supernach00/AGSE-Proyecto-Final/Informe/Proyecto_Zero-1.pdf

# Proyecto Zero

# Chantiri, Ignacio Nahuel 69869/1 Fernandez Madau, Esteban 71271/5

## Facultad de Ingeniería de la Universidad Nacional de La Plata, 2026

### 1. Resumen

Se propone el diseno del generador digital-anal ˜ | ogico de se ´ | nales en el rango auditivo com- ˜
prendido entre 5Hz y 5KHz, y la comunicacion del producto final con el software de PC que ´ permite el control y la visualizacion de los datos. ´
Este proyecto comprende una aproximacion a la s ´ | íntesis de senales digitales, particularmen- ˜
te del tipo senoidal y a la seleccion de un microcontrolador adecuado para proyecto. ´

### 2. Objetivos

Este Proyecto Zero tiene los siguientes objetivos particulares:
Determinar los requerimientos que demanda el proyecto total para poder realizar una correcta eleccion del microcontrolador. ´
Familizarizarse con el microcontrolador elegido y las herramientas ofrecidas por el fabricante del mismo.
Estudiar la viabilidad de las distintas maneras de generar la senal de manera digital, de- ˜ terminar los límites o complicaciones con el microcontrolador elegido.
Implementar la generacion digital de una se ´ | nal senoidal de dos canales, de par ˜ | ametros ´
variables (frecuencia y amplitud) por comandos desde la pc.

### 3. Tareas realizadas y resultados obtenidos

### 3.1 Eleccion del Microcontrolador ´

Se lista, en orden de importancia, las características del microcontrolador STM32F446RCT7 y las razones que llevaron a su eleccion para este proyecto. ´
1. Interfaz SAI / I²S: dispone de interfaces de audio digital adecuadas para la comunicacion´ con un codec, permitiendo transmitir y recibir muestras digitales de hasta 24 bits.
2. DMA: permite transferir automaticamente las muestras entre la memoria y los perif ´ | ericos ´
de audio, reduciendo la carga de procesamiento de la CPU y facilitando la transmision´ continua de senales. ˜
3. Frecuencia de operacion: ´ | hasta 180 MHz, proporcionando un amplio margen de proce-
samiento para la generacion y adquisici ´ | on de se ´ | nales en tiempo real. ˜
4. Temporizadores: dispone de multiples temporizadores que permiten establecer una fre- ´
cuencia de muestreo precisa y generar las senales de sincronizaci ˜ | on necesarias para el ´
procesamiento de audio.
5. N úcleo ARM Cortex-M4 con DSP: incorpora instrucciones específicas para procesa-
miento digital de senales, ˜ | utiles para implementar filtros, generaci ´ | on de se ´ | nales y algo- ˜
ritmos de procesamiento.
6. Unidad de punto flotante (FPU): permite realizar operaciones en punto flotante de preci-
sion simple de manera eficiente, facilitando la implementaci ´ | on de algoritmos matem ´ | aticos ´
y de procesamiento de senales. Se toma en cuenta puesto que se contempla que otra ˜
parte del proyecto requiera calculos demandantes para procesamiento de se ´ | nales. ˜
7. Memoria SRAM: dispone de 128 KB de SRAM, permitiendo almacenar buffers de audio y datos utilizados durante el procesamiento en tiempo real.
8. Memoria Flash: dispone de 256 KB de memoria Flash, suficiente para almacenar el firmware, tablas de consulta (LUT) y constantes utilizadas por el sistema.
9. DAC: incorpora dos convertidores digital–analogico de 12 bits, ´ | utiles para realizar prue- ´
bas de generacion de se ´ | nales directamente desde el microcontrolador, como se da en ˜
este Proyecto Zero.
10. Capacidad para implementar DDS: Todo lo mencionado permite implementar un sintetizador digital directo mediante un acumulador de fase y una tabla de consulta (LUT),
posibilitando la generacion de se ´ | nales sinusoidales y otras formas de onda con frecuencia ˜
configurable.
Se contemplaron ademas otros microcontroladores con características similares ´
como el stm32f411, pero la seleccion termin ´ | o decantando en base a la accesibili- ´
dad de los mismos.
3.2 Generacion de la se ´ | nal sinusoidal ˜

El siguiente diagrama busca representar el algoritmo implementado por codigo en el micro- ´ controlador. El objetivo es lograr controlar independientemente dos canales de audio (dos DACs), generando la senal senoidal que puede ser modificable tanto en frecuencia como en ˜ amplitud.
La síntesis digital se basa en el uso de una tabla (LUT) para acceder a los distintos valores de la senal senoidal. La tabla se recorre con un cierto paso configurable (FTW), permitiendo ˜ variar la frecuencia de la senal de salida. La amplitud se modula escalando los valores de ˜ dicha tabla.
El acumulador de fase (acc) corresponde a una variable de 32 bits que va incrementando
segun el FTW cada tiempo de muestreo ´ | fs (48Khz, fijado por el codec que se utilizara a ´
futuro). El valor almacenado de la fase luego se utiliza para acceder a la LUT, truncando previamente para adaptar a la cantidad de puntos de la tabla.

Por ultimo se aplica un control de amplitud de varios pasos, que incluye el centrado a cero, ´ escalado y descentrado nuevamente de la senal para luego ser enviada al DAC. ˜
La generacion implementada trabaja con dos canales (L/R), por lo que el proceso que ´ se describio se realiza de manera similar y en ”paralelo”para ambos. ´

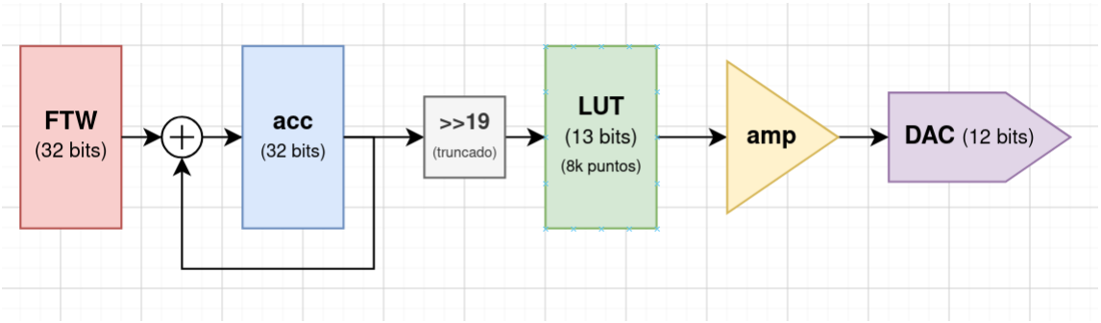
[picture p9: figure]

Algoritmo de Síntesis de la Senal Senoidal ˜

La LUT se selecciono con 8192 puntos, utilizando 13 bits del acumulador de fase para su ´ direccionamiento. Esta cantidad de puntos permite obtener una resolucion angular suficien- ´ temente elevada, reduciendo el error asociado al truncamiento de fase.
Ademas, se consider ´ | o el tama ´ | no que ocupa en flash: 8192 * 2Bytes = 16.384 Bytes, despre- ˜
ciable considerando el total de 256Kbytes
De esta manera, la frecuencia de la senal generada queda definida por: ˜

fout =

F TW
2N

fs

donde:

fs = 48 kHz es la frecuencia de muestreo.

N = 32 es la cantidad de bits del acumulador de fase.

F TW es la palabra de ajuste de frecuencia.

Si se utilizan los 13 bits mas significativos del acumulador para determinar el ´ | índice de la
tabla:

índice =

acumulador
2

32−13

índice = acumulador ≫ 19

Por lo tanto, la frecuencia de salida queda determinada por:

fout =

F TW
2

32

- 48 kHz

Mientras que los 13 bits utilizados para direccionar la LUT determinan la resolucion de fase ´ de la tabla:

2

13 = 8192 puntos

Así, el F TW determina la frecuencia de salida, mientras que la cantidad de puntos de la LUT determina la resolucion con la que se representa la forma de onda. ´

### 3.3 Circuito de prueba

Diagrama

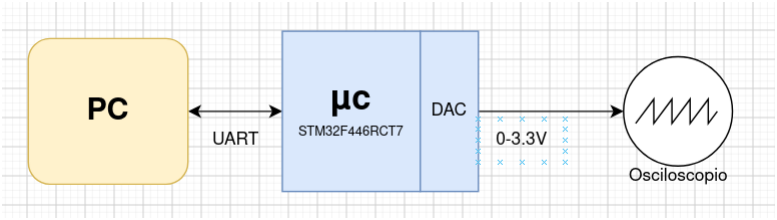
[picture p10: figure]

simplificado de la prueba realizada

El siguiente es el diagrama circuital del sistema:

Circuito

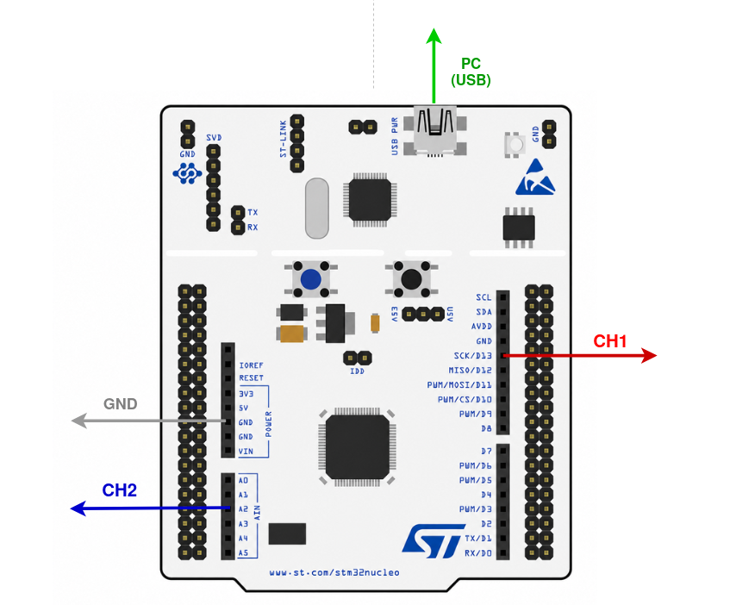
[picture p11: figure]

de prueba.

CH1, CH2 corresponden a las puntas de prueba del osciloscopio. Permanecen conectadas al DAC1 y al DAC2 respectivamente.
GND corresponde a la conexion de tierra del osciloscopio. ´

El circuito de prueba requiere los siguientes materiales:

STM32F446RE (placa de desarrollo con microcontrolador de características similares al STM32F446RCT7).

Osciloscopio

Cables

PC, cable usb mini.

### 3.4 Resultados

Se presentan las mediciones con osciloscopio de senales generadas por el circuito propues- ˜ to, configurandose a distintas frecuencias: ´

Senal generada ˜


a frecuencia de 1Khz

Senal generada ˜


a frecuencia de 2Khz

Senal generada ˜

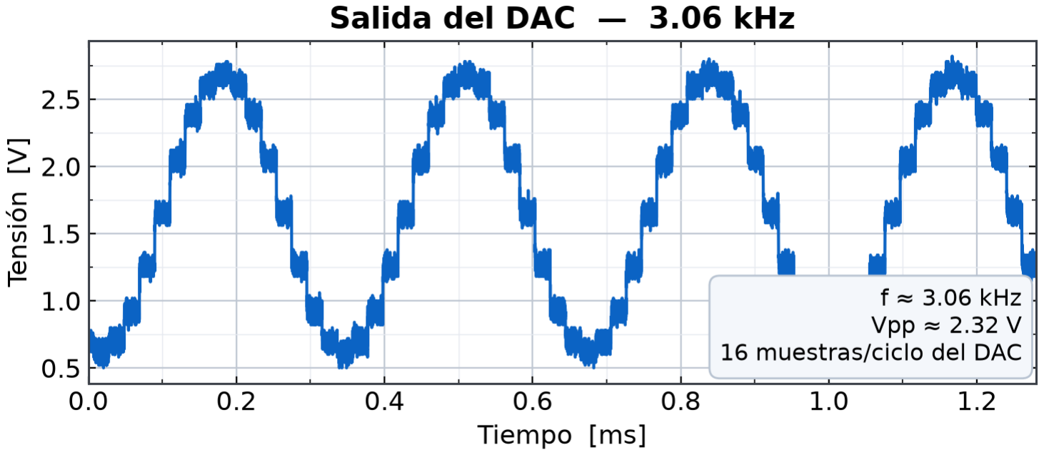
[picture p12: figure]

a frecuencia de 3Khz

Senal generada ˜


a frecuencia de 4Khz

Senal generada ˜

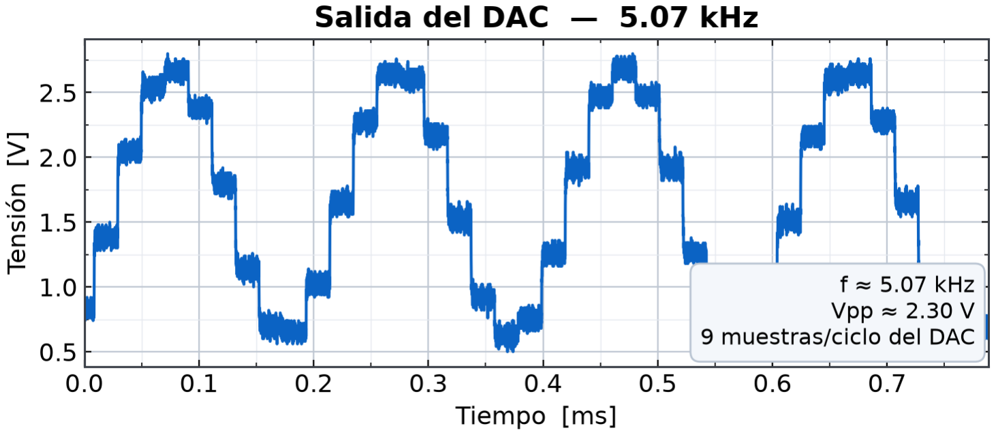
[picture p13: figure]

a frecuencia de 5Khz

Muestra del

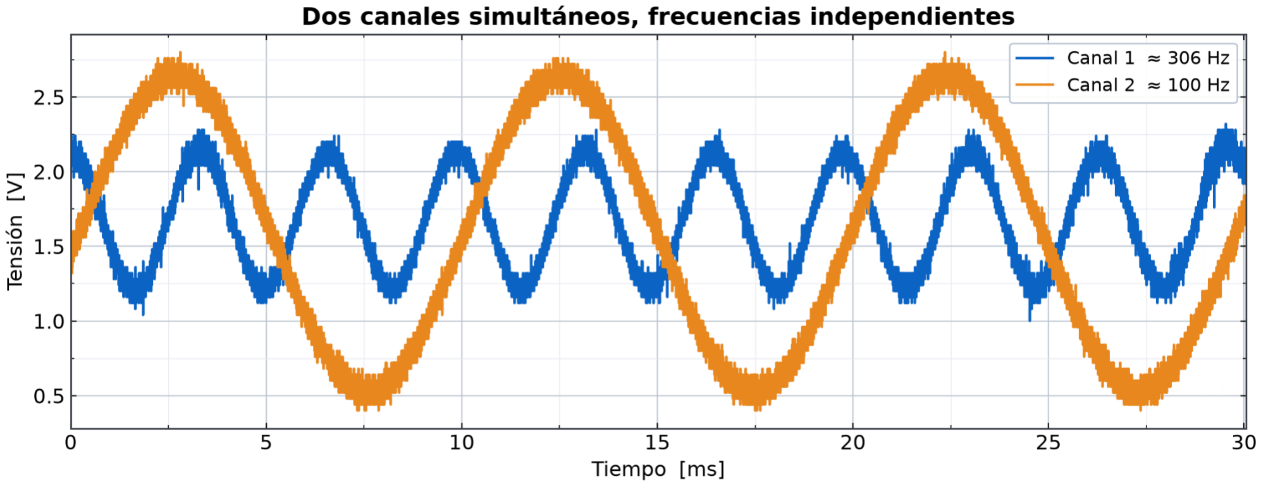
[picture p14: figure]

funcionamiento de dos canales.

Con una frecuencia de muestreo de fs = 48 kHz, la cantidad de muestras por período de la senal est ˜ a dada por: ´

Nmuestras =

fs

fout
Por lo tanto:
1 kHz → 48 muestras/ciclo. 2 kHz → 24 muestras/ciclo. 3 kHz → 16 muestras/ciclo. 4 kHz → 12 muestras/ciclo.

5 kHz → 9,6 muestras/ciclo.
Se observa que, a medida que aumenta la frecuencia de la senal generada, disminuye la ˜ cantidad de muestras disponibles para representar cada período. En particular, a 5 kHz se dispone de menos de 10 muestras por período, lo que explica el aumento de los escalones observados en la senal. ˜

Se espera que el ruido del DAC se vea reducido en etapas posteriores de filtrado, como a su vez los escalones no tan pronunciados.

Los escalones observados corresponden a la representacion discreta de la se ´ | nal y pue- ˜
den reducirse mediante un filtro de reconstruccion pasabajos posterior al codec, cuya fun- ´
cion ser ´ | a atenuar las componentes espectrales asociadas al muestreo y suavizar la se ´ | nal ˜
analogica. ´

### 4. Conclusiones

Se considera que este proyecto es un buen primer paso para evaluar las posiblidades de
generacion de se ´ | nales. Los resultados obtenidos son satisfactorios, particularmente a fre- ˜
cuencias bajas.

Gracias a estos ensayos, tenemos claras las capacidades de resolucion siendo la frecuencia ´
de muestreo de 48KHz un parametro fijo en el dise ´ | no, dado por el codec, y abre tambi ˜ | en la ´
puerta a la busqueda de soluciones alternativas para reducir los errores a frecuencias altas. ´
No se evaluo en este proyecto, pero podr ´ | ía haber sido de utilidad filtrar las senales con un ˜
circuito pasabajos sencillo, para darnos una idea de que tanto se puede mejorar la senal una ˜ vez filtrada.

### 5. Bibliografía

La implementacion se bas ´ | o fuertemente en el art ´ | ículo tecnico de Patrick Butler, publicado ´
por Analog Devices:

An Almost Pure DDS Sine Wave Tone Generator (https://www.analog.com/en/resources/technical-articles/an-almost-pure-dds-sine-wave-tone-generator.html)
