supernach00/AGSE-Proyecto-Final/Blackpill_codec_V2/config_clock.png

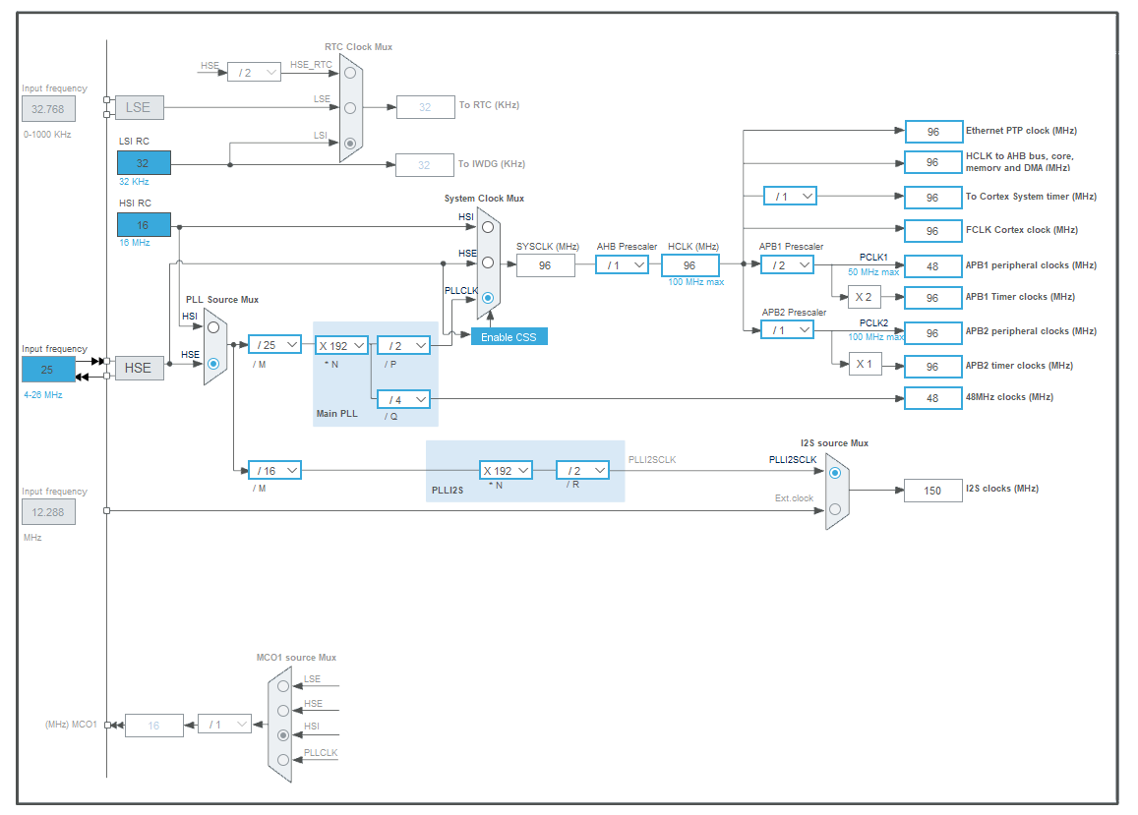
Blackpill_codec_V2/config_clock.png
