supernach00/AGSE-Proyecto-Final/Blackpill_codec_V2/config_i2s2.png

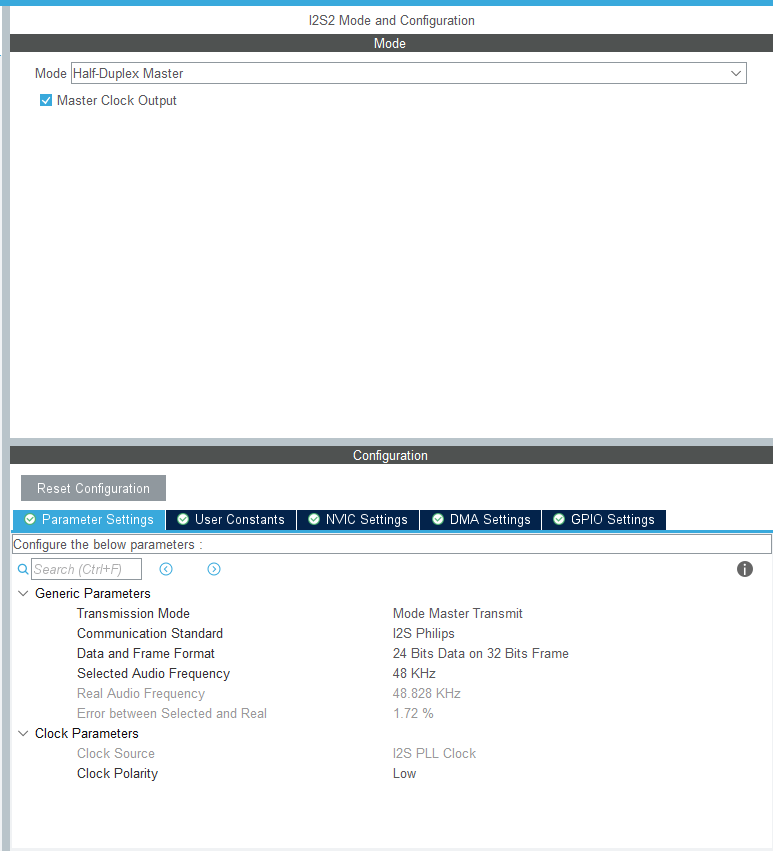
Blackpill_codec_V2/config_i2s2.png
