supernach00/AGSE-Proyecto-Final/Blackpill_codec_V2/mapeo de pines.png

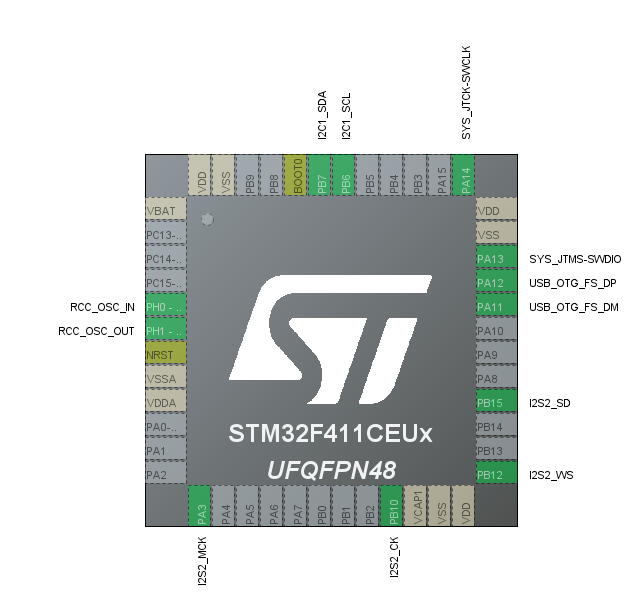
Blackpill_codec_V2/mapeo de pines.png
