supernach00/AGSE-Proyecto-Final/Blackpill_codec_V2/Tabla funciones configurables.png

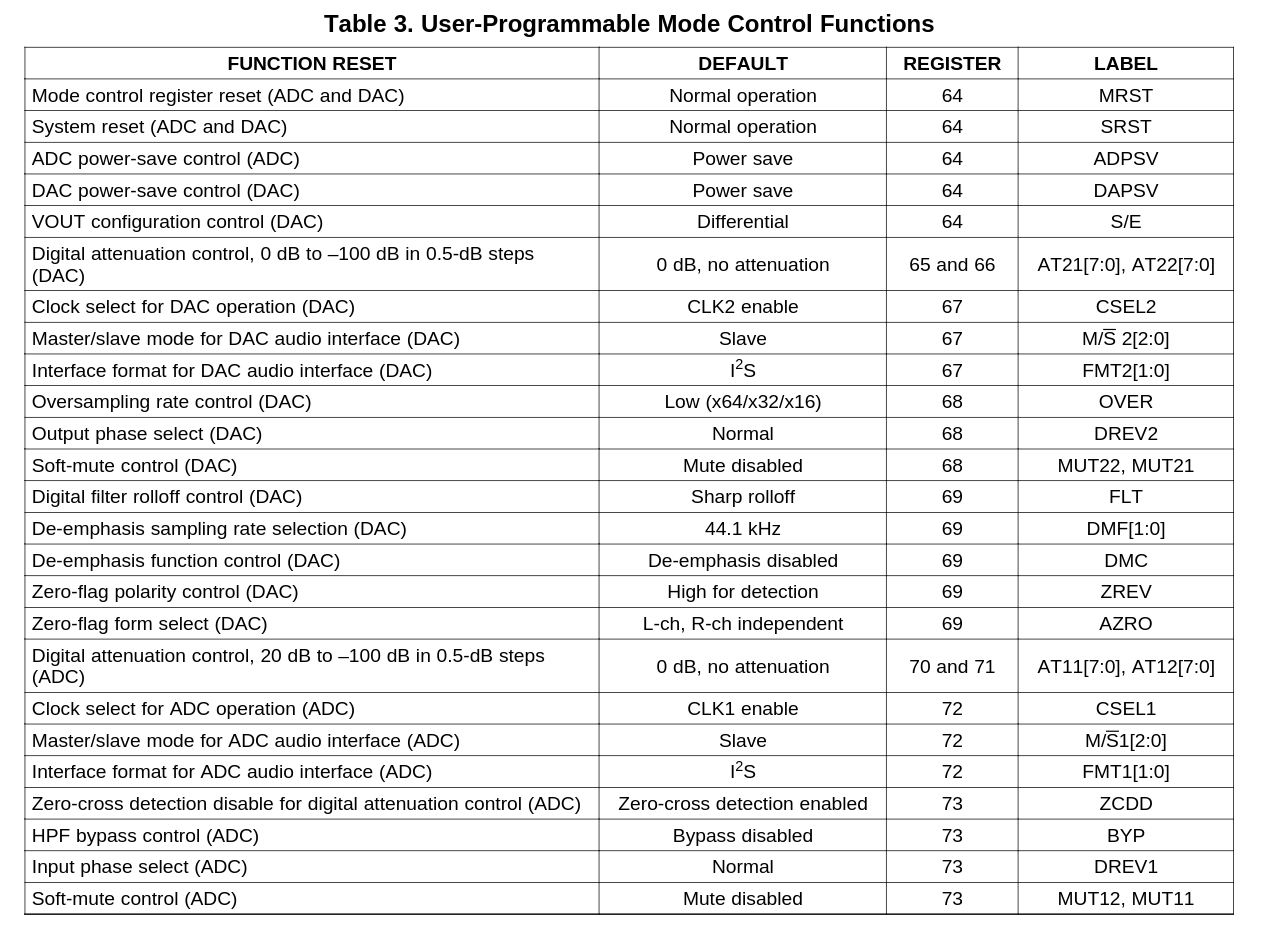
Blackpill_codec_V2/Tabla funciones configurables.png
