supernach00/AGSE-Proyecto-Final/Esquematicos-pcb/GRB.pdf

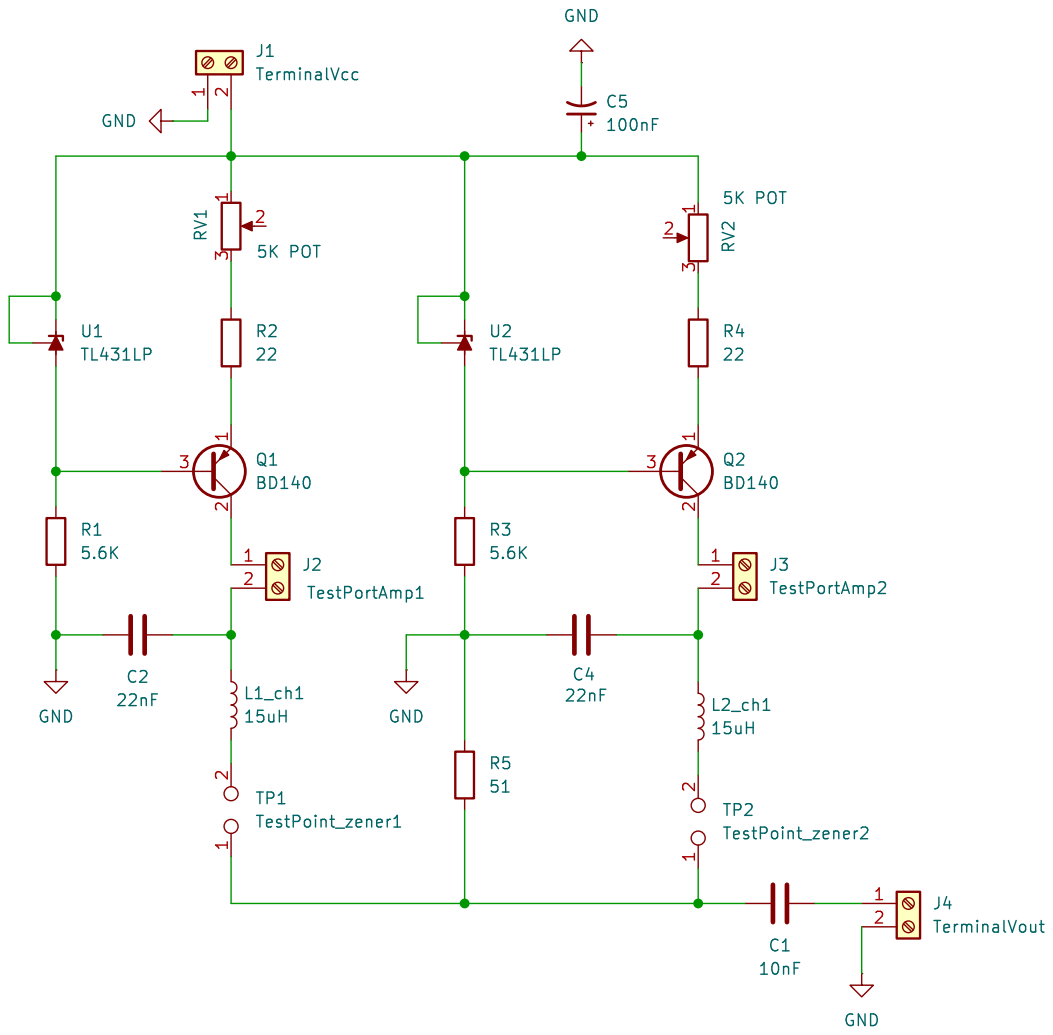
[picture p19: page 1]

Id: 1/1 Title: File: GeneradorRuido.kicad_sch Sheet: / C2
