supernach00/AGSE-Proyecto-Final/pcb/pcb_final/pcb_stm32f411/pcb_stm32f411.kicad_sch

## KiCad design pcb/pcb_final/pcb_stm32f411/pcb_stm32f411.kicad_sch (2026-10-28)

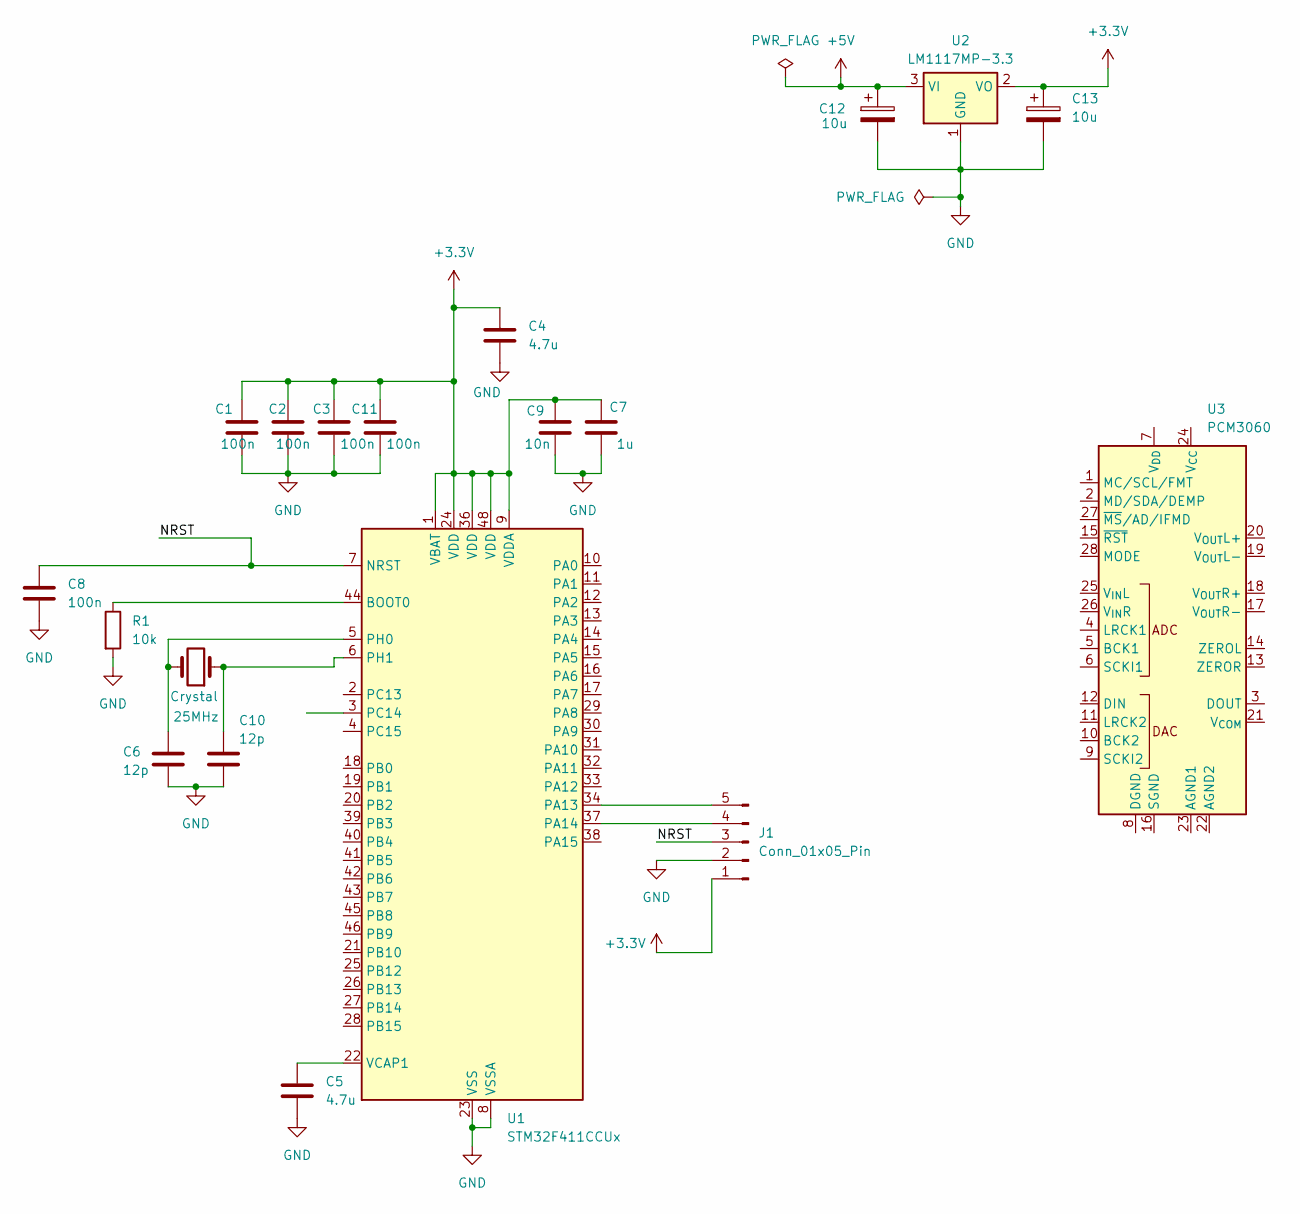
[picture p20: schematic pcb_stm32f411.kicad_sch]

Parts:
25MHz: Crystal
C1, C2, C3, C8, C11: 100n
C4, C5: 4.7u
C6, C10: 12p
C7: 1u
C9: 10n
C12, C13: 10u
J1: Conn_01x05_Pin
R1: 10k
U1: STM32F411CCUx; QFN-48-1EP_7x7mm_P0.5mm_EP5.6x5.6mm
U2: LM1117MP-3.3; SOT-223-3_TabPin2
U3: PCM3060; TSSOP-28_4.4x9.7mm_P0.65mm

Connections:
+3.3V: C1.1, C2.1, C3.1, C4.1, C7.1, C9.1, C11.1, C13.1, J1.1, U1.1 (VBAT), U1.9 (VDDA), U1.24 (VDD), U1.36 (VDD), U1.48 (VDD), U2.2 (VO)
+5V: C12.1, U2.3 (VI)
GND: C1.2, C2.2, C3.2, C4.2, C5.2, C6.2, C7.2, C8.2, C9.2, C10.2, C11.2, C12.2, C13.2, J1.2, R1.2, U1.8 (VSSA), U1.23 (VSS), U1.35 (VSS), U1.47 (VSS), U1.49 (VSS), U2.1 (GND)
NRST: C8.1, J1.3, U1.7 (NRST)
unnamed: 25MHz.1, C10.1, U1.6 (PH1)
unnamed: 25MHz.2, C6.1, U1.5 (PH0)
unnamed: C5.1, U1.22 (VCAP1)
unnamed: J1.4, U1.37 (PA14)
unnamed: J1.5, U1.34 (PA13)
unnamed: R1.1, U1.44 (BOOT0)
