supernach00/AGSE-Proyecto-Final/Blackpill_codec_V2/Version V2.ioc

Mcu.UserName=STM32F411CEUx
PA0-WKUP.Signal=GPIO_Output
PA1.Signal=GPIO_Output
PA11.Signal=USB_OTG_FS_DM
PA12.Signal=USB_OTG_FS_DP
PA13.Signal=SYS_JTMS-SWDIO
PA14.Signal=SYS_JTCK-SWCLK
PA3.Signal=I2S2_MCK
PB0.Signal=GPIO_Output
PB1.Signal=GPIO_Output
PB10.Signal=I2S2_CK
PB12.Signal=I2S2_WS
PB13.Signal=GPIO_Input
PB14.Signal=GPIO_Input
PB15.Signal=I2S2_SD
PB6.Signal=I2C1_SCL
PB7.Signal=I2C1_SDA
PB8.Signal=GPIO_Input
PB9.Signal=GPIO_Input
