supernach00/AGSE-Proyecto-Final/Blackpill_codec_V2/Core/Inc/sine_table.h

// Tabla senoidal DDS: 8192 puntos, 24 bits con signo (+-8388607)
// Generada en MATLAB para el codec PCM3060 (24 bits)
#ifndef SINE_TABLE_H
#define SINE_TABLE_H
#include <stdint.h>

#define SINE_N 8192

static const int32_t sine_table[8192] = {
0, 6434, 12868, 19302, 25736, 32170, 38604, 45038, 
51472, 57905, 64339, 70773, 77207, 83640, 90074, 96508, 
102941, 109375, 115808, 122241, 128675, 135108, 141541, 147974, 
154407, 160840, 167272, 173705, 180138, 186570, 193002, 199435, 
205867, 212299, 218731, 225162, 231594, 238025, 244457, 250888, 
257319, 263750, 270180, 276611, 283041, 289472, 295902, 302332, 
308761, 315191, 321620, 328049, 334478, 340907, 347336, 353764, 
360192, 366620, 373048, 379475, 385903, 392330, 398756, 405183, 
411609, 418036, 424461, 430887, 437312, 443737, 450162, 456587, 
463011, 469435, 475859, 482282, 488706, 495129, 501551, 507974, 
514396, 520817, 527239, 533660, 540081, 546501, 552921, 559341, 
565761, 572180, 578599, 585017, 591435, 597853, 604270, 610687, 
617104, 623521, 629937, 636352, 642767, 649182, 655597, 662011, 
668425, 674838, 681251, 687663, 694076, 700487, 706899, 713309, 
719720, 726130, 732540, 738949, 745358, 751766, 758174, 764581, 
770988, 777395, 783801, 790206, 796611, 803016, 809420, 815824, 
822227, 828630, 835032, 841434, 847835, 854236, 860636, 867036, 
873435, 879834, 886232, 892630, 899027, 905424, 911820, 918216, 
924611, 931005, 937399, 943793, 950186, 956578, 962970, 969361, 
975751, 982141, 988531, 994920, 1001308, 1007696, 1014083, 1020469, 
1026855, 1033240, 1039625, 1046009, 1052393, 1058775, 1065158, 1071539, 
1077920, 1084300, 1090680, 1097059, 1103438, 1109815, 1116192, 1122569, 
1128945, 1135320, 1141694, 1148068, 1154441, 1160814, 1167185, 1173556, 
1179927, 1186296, 1192665, 1199034, 1205401, 1211768, 1218134, 1224500, 
1230864, 1237228, 1243592, 1249954, 1256316, 1262677, 1269037, 1275397, 
1281756, 1288114, 1294471, 1300827, 1307183, 1313538, 1319892, 1326246, 
1332599, 1338950, 1345302, 1351652, 1358001, 1364350, 1370698, 1377045, 
1383391, 1389737, 1396081, 1402425, 1408768, 1415111, 1421452, 1427792, 
1434132, 1440471, 1446809, 1453146, 1459482, 1465818, 1472152, 1478486, 
1484819, 1491151, 1497482, 1503812, 1510141, 1516470, 1522797, 1529124, 
1535450, 1541775, 1548098, 1554421, 1560744, 1567065, 1573385, 1579704, 
1586023, 1592340, 1598657, 1604972, 1611287, 1617601, 1623913, 1630225, 
1636536, 1642846, 1649155, 1655463, 1661770, 1668076, 1674381, 1680685, 
1686988, 1693290, 1699591, 1705891, 1712190, 1718488, 1724785, 1731081, 
1737376, 1743670, 1749963, 1756255, 1762546, 1768835, 1775124, 1781412, 
1787699, 1793984, 1800269, 1806553, 1812835, 1819116, 1825397, 1831676, 
1837954, 1844231, 1850507, 1856782, 1863056, 1869329, 1875600, 1881871, 
1888140, 1894409, 1900676, 1906942, 1913207, 1919471, 1925734, 1931995, 
1938256, 1944515, 1950773, 1957030, 1963286, 1969541, 1975794, 1982047, 
1988298, 1994548, 2000797, 2007045, 2013291, 2019536, 2025781, 2032023, 
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
};

#endif
