supernach00/AGSE-Proyecto-Final/(commit log)

2026-09-07 Primer iteracion
    [AGSE.kicad_pcb, AGSE.kicad_sch]
2026-09-07 Generador v3: doble canal DAC con frecuencia y amplitud independientes por UART
    - Reemplazo p_zero por la version limpia (sin la carpeta Debug ni cruft de CMSIS)
    - DAC 2 canales (PA4/PA5), DDS con tabla de 8192 puntos a fs=48kHz
    - Control por terminal: frecuencia, espacio=cambia canal, p/s=play/stop, +/-=amplitud
    - Agrego .gitignore para no subir mas los binarios de compilacion
2026-09-08 Agrego la presentacion del Proyecto Cero (generador DDS)
2026-09-09 Actualizo la presentacion del Proyecto Cero (version final)
2026-09-14 Agrego el firmware de la Black Pill (F411) con el codec PCM3060 por I2S
2026-09-17 Agrego la version V2 del firmware Black Pill + PCM3060 (audio 24 bits por I2S) y la chuleta de referencia
2026-09-23 Agregar manejo por usb y script de python para enviar comandos
2026-09-23 Agregar codigo para interpretar los comandos que llegan por usb. Queda funcional para un canal
2026-09-24 Modificar el menu de python para que tenga dos canales
2026-09-24 Agrego formas de onda (triangular, chirp, cuadrada) y pantalla OLED con la forma, frecuencia y amplitud
2026-09-24 Agrego teclado 4x4, formas de onda por canal, seleccion de forma y salida diferencial/simple desde la app, y doc de cambios
2026-09-24 Ignoro archivos temporales de Python (__pycache__)
2026-09-24 Amplitud independiente por canal (cada canal escribe su propio registro de volumen del codec)
2026-09-24 Limpieza: saco variables y defines de amplitud/on-off que ya no se usaban
2026-10-28 Agregar diseño de PCB en KiCad (preliminar y final STM32F411)
