supernach00/AGSE-Proyecto-Final/(notices)

Notices in the files:
Blackpill_codec_V2/Core/Src/main.c:
Copyright (c) 2026 STMicroelectronics.
All rights reserved.
This software is licensed under terms that can be found in the LICENSE file
